AlexIII/weather-node/img/wns-screen-emu.png

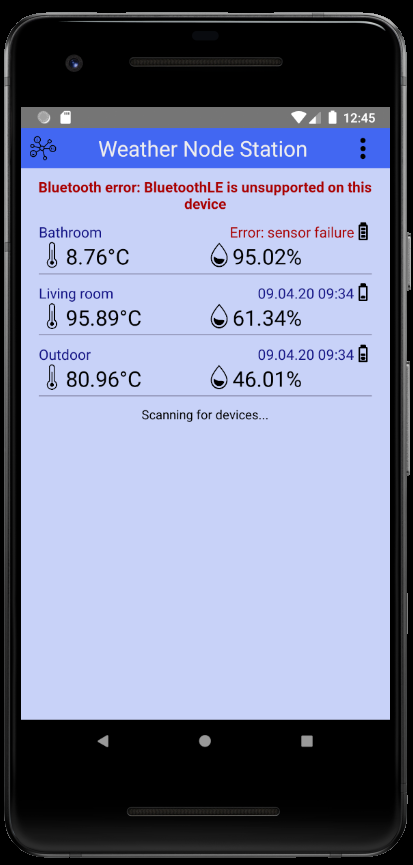
img/wns-screen-emu.png
