AlexIII/weather-node/(commit log)

2020-04-25 wn1-fw: fix humidity/temperature order
    [dht22.h, main.c]
2020-04-25 add Arduino-based Weather Node
